mszkowalik/CE_Dongle_v3_schematic/docs/components/optical_interface.MD

Devices with similar functionality
## onemeter
https://onemeter.com/
## PiggyMeter
https://aquaticus.info/meter.html#meters-reported-to-work-with-piggymeter

In Poland most meter use IEC 62056-21

Tasmota supports Meter decoding using Sensor53
https://tasmota.github.io/docs/Smart-Meter-Interface/

Example circuit:
https://github.com/twam/IEC-62056-21-Optical-Probe
