mszkowalik/CE_Dongle_v3_schematic/enclosure/CE_Dongle_V3_3.FCStd

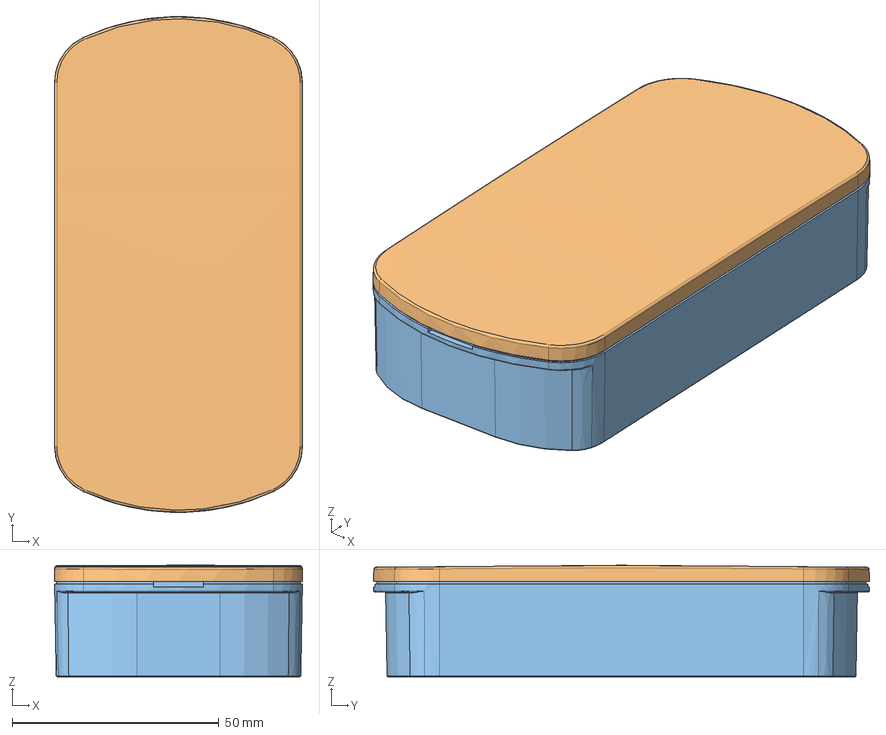
[picture p1: CAD file, 2026-07-19]
enclosure/CE_Dongle_V3_3.FCStd
60.0 x 120.0 x 27.0 mm
Binder
SICC6-12_HP\X2\7528\X0\
SIMB6-12-3W_HP\X2\7528\X0\
SIMM4-5W_HP\X2\7528\X0\
