mszkowalik/CE_Dongle_v3_schematic/enclosure/V3_0/1551RFL.stp

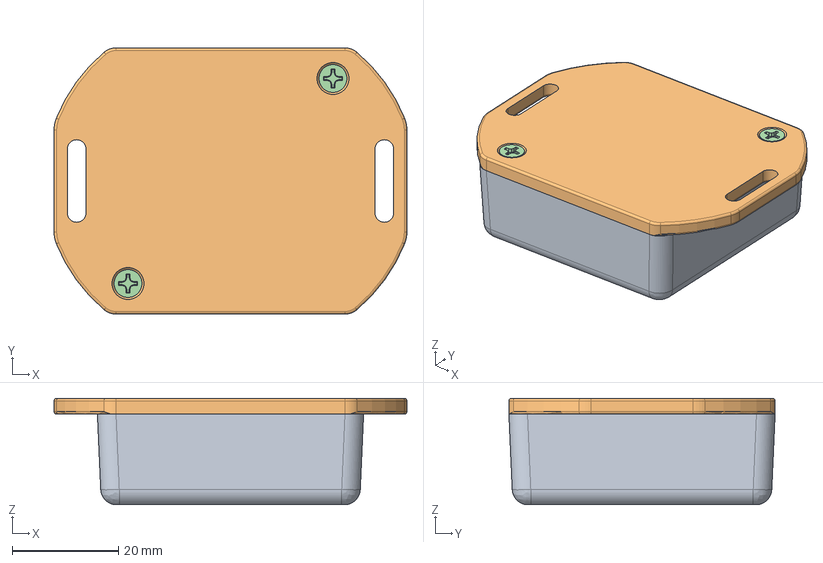
[picture p2: CAD file, 2026-05-01]
enclosure/V3_0/1551RFL.stp
66.3 x 50.0 x 20.0 mm
1551R Box
1551R-S Flange Lid
1551R-S PCB
