mszkowalik/CE_Dongle_v3_schematic/enclosure/V3_0/CE_Dongle_v3_pcb-base.3mf

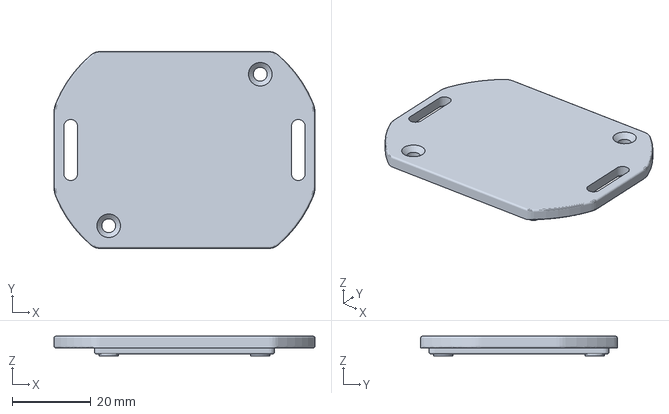
[picture p3: CAD file, 2026-05-01]
enclosure/V3_0/CE_Dongle_v3_pcb-base.3mf
66.3 x 50.0 x 5.00 mm
