mszkowalik/CE_Dongle_v3_schematic/enclosure/CE_Dongle_V3_3-BodySketch.dxf

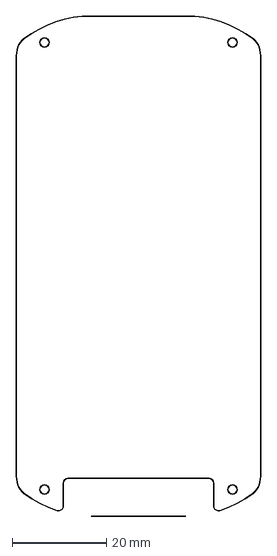
[picture p4: CAD file, 2026-07-19]
enclosure/CE_Dongle_V3_3-BodySketch.dxf
52.0 x 106.3 mm
