mszkowalik/CE_Dongle_v3_schematic/enclosure/V3_0/CE_Dongle_v3_pcb-otwory.3mf

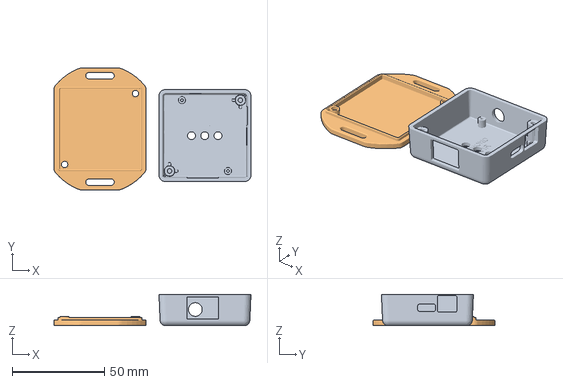
[picture p5: CAD file, 2026-05-01]
enclosure/V3_0/CE_Dongle_v3_pcb-otwory.3mf
107.0 x 66.3 x 17.0 mm
