mszkowalik/CE_Dongle_v3_schematic/enclosure/1551XFLGY.stp

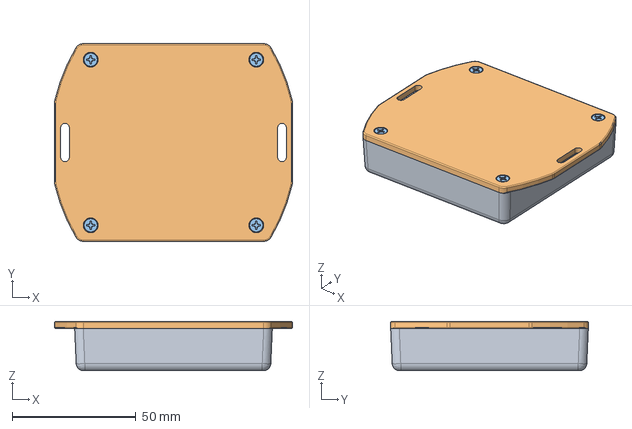
[picture p6: CAD file, 2026-07-05]
enclosure/1551XFLGY.stp
96.3 x 80.0 x 20.0 mm
1551W Box
1551W Flange Lid
