mszkowalik/CE_Dongle_v3_schematic/enclosure/CE_Dongle_v3_enc_milling.3mf

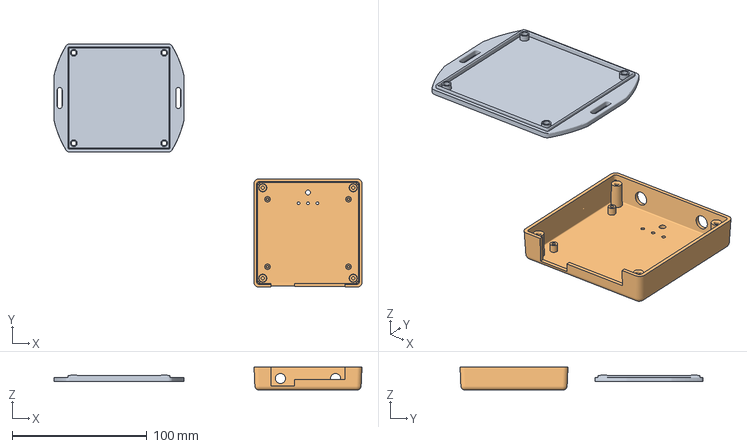
[picture p7: CAD file, 2026-07-05]
enclosure/CE_Dongle_v3_enc_milling.3mf
228.2 x 180.0 x 17.0 mm
