mszkowalik/CE_Dongle_v3_schematic/enclosure/CE_Dongle_v3_pcb.FCStd

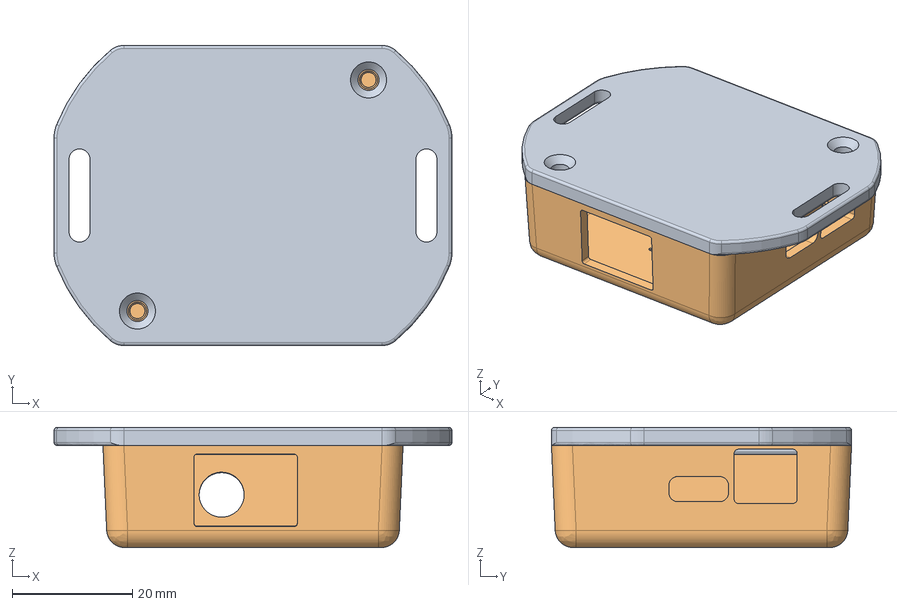
[picture p8: CAD file, 2026-05-01]
enclosure/CE_Dongle_v3_pcb.FCStd
66.3 x 50.0 x 20.0 mm
_551RFL001
