mszkowalik/CE_Dongle_v3_schematic/(list of files, cad)

Other CAD files:
enclosure/SIM6-12-3W.dxf
enclosure/CE_Dongle_v3_pcb.3mf
enclosure/V3_0/1551RFL.igs
