mszkowalik/CE_Dongle_v3_schematic/src/CE_Dongle_V3.kicad_pcb

## KiCad design src/CE_Dongle_V3.kicad_pcb (2026-07-22)

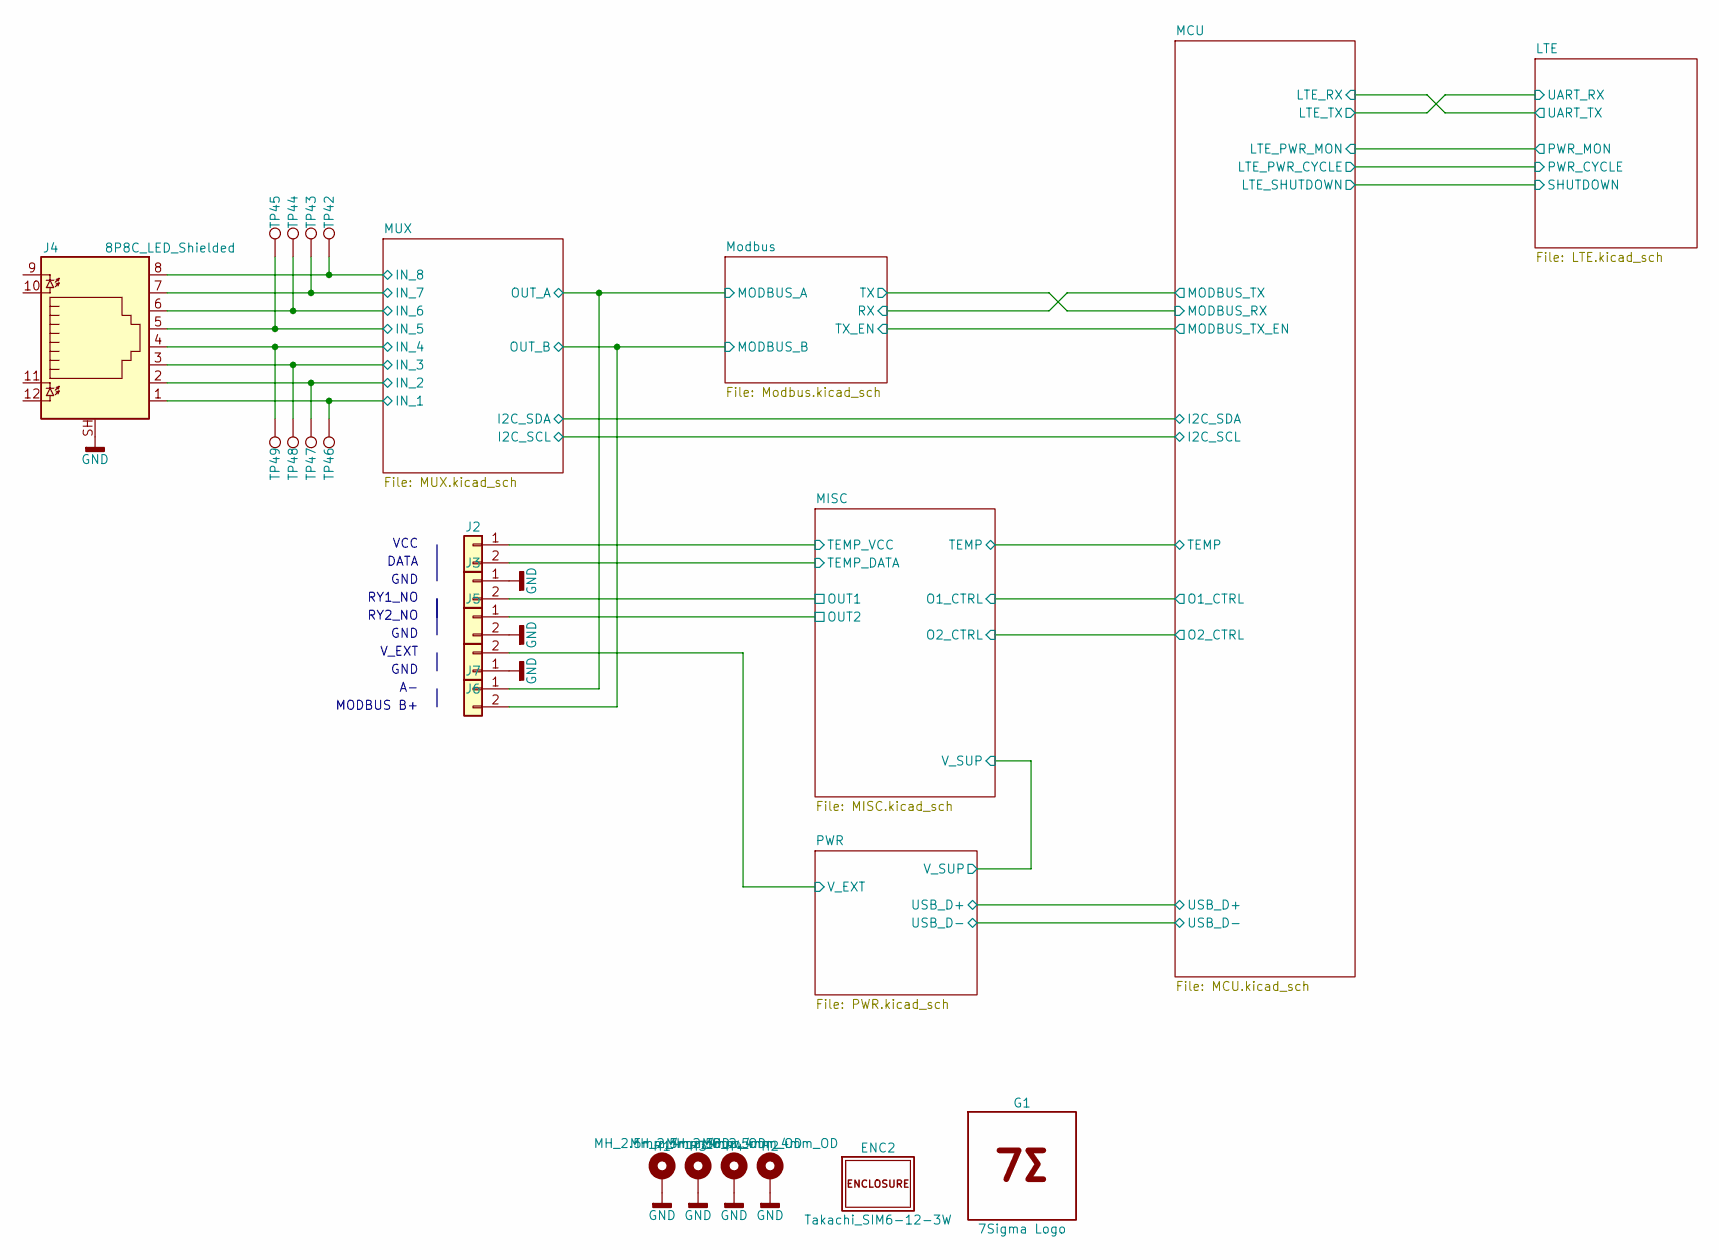
[picture p9: schematic CE_Dongle_V3.kicad_sch]

Parts:
ENC2: Takachi_SIM6-12-3W; TAKACHI_SIM6-12-3W; Manufacturer Part Numbe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 SIM6-12-3W
G1: 7Sigma Logo; 7Sigma_Logo
H1, H2, H3, H4: MH_2.5mm_4mm_OD; MountingHole_2.5mm_Pad_4mm
J2, J3, J5, J6, J7: Conn_01x02; CONN-TH_XY302V-3.5-2P; Manufacturer Part Numbe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 XY302V-3.5-2P; LCSC Part C784940
J4: 8P8C_LED_Shielded; RJ45-TH_RC01812; Manufacturer Part Numbe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 RC01812; LCSC Part C708645
TP42, TP43, TP44, TP45, TP46, TP47, TP48, TP49: TestPoint; TestPoint_Pad_D1.5mm

Connections:
/MISC/OUT1: J3.2; also elsewhere on the board
/MISC/OUT2: J5.1; also elsewhere on the board
/MISC/TEMP_DATA: J2.2; also elsewhere on the board
/MISC/TEMP_VCC: J2.1; also elsewhere on the board
/MUX/IN_1: J4.1, TP46.1 (1_1); also elsewhere on the board
/MUX/IN_2: J4.2, TP47.1 (1_1); also elsewhere on the board
/MUX/IN_3: J4.3, TP48.1 (1_1); also elsewhere on the board
/MUX/IN_4: J4.4, TP49.1 (1_1); also elsewhere on the board
/MUX/IN_5: J4.5, TP45.1 (1_1); also elsewhere on the board
/MUX/IN_6: J4.6, TP44.1 (1_1); also elsewhere on the board
/MUX/IN_7: J4.7, TP43.1 (1_1); also elsewhere on the board
/MUX/IN_8: J4.8, TP42.1 (1_1); also elsewhere on the board
/MUX/OUT_A: J7.1; also elsewhere on the board
/MUX/OUT_B: J7.2; also elsewhere on the board
/PWR/V_EXT: J6.2; also elsewhere on the board
GND: H1.1 (1_1), H2.1 (1_1), H3.1 (1_1), H4.1 (1_1), J3.1, J4.SH, J5.2, J6.1; also elsewhere on the board

Notes on the sheet:
VCC
GND
V_EXT
RY1_NO
DATA
MODBUS B+
RY2_NO

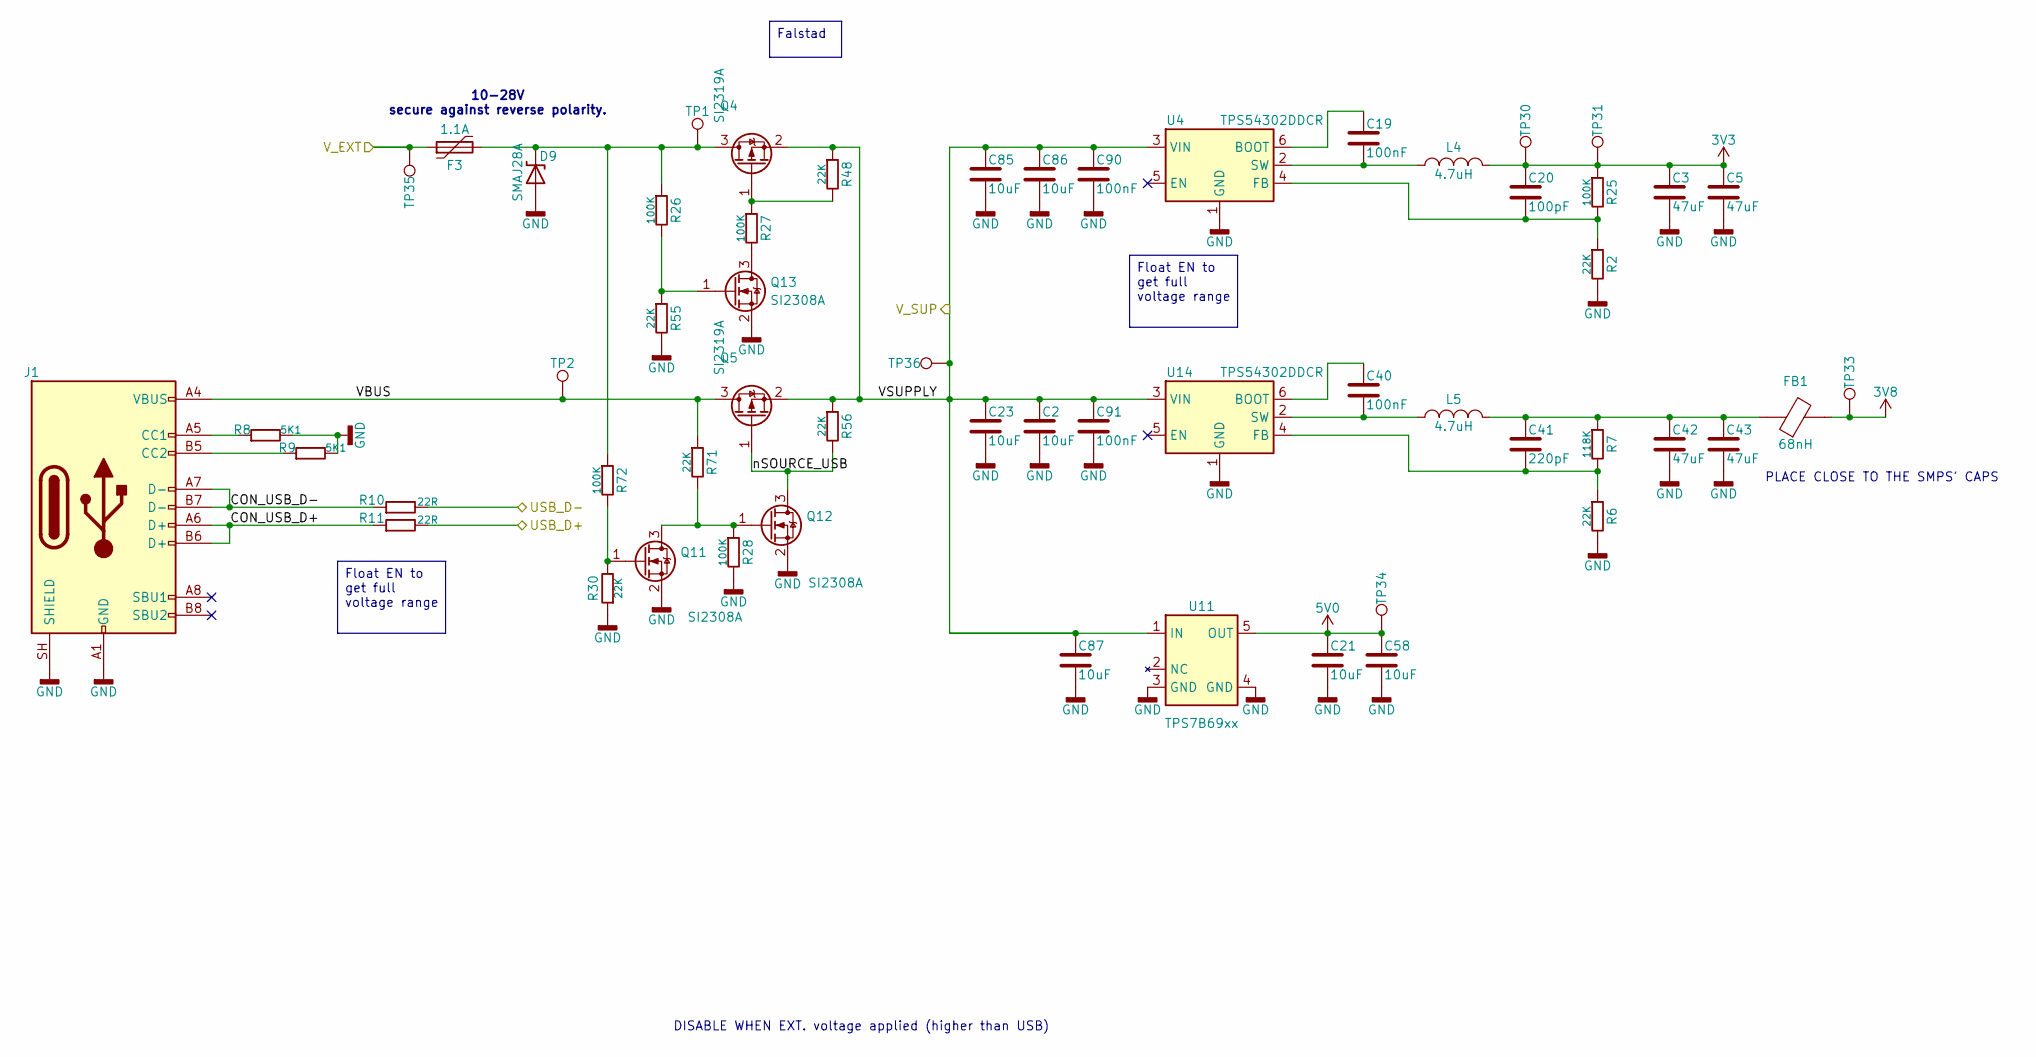
[picture p10: schematic PWR.kicad_sch]

Parts:
C2, C21, C23, C58, C85, C86, C87: 10uF; C_0805_2012Metric; Voltage 50V; Tolerance 10%; Manufacturer Part Numbe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 GRM21BR61H106KE43L; LCSC Part C440198
C3, C5, C42, C43: 47uF; C_1210_3225Metric; Voltage 16V; Tolerance 10%; Manufacturer Part Numbe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 CS3225X7R476K160NRL; LCSC Part C5440143
C19, C40, C90, C91: 100nF; C_0402_1005Metric; Voltage 16V; Tolerance 10%; Manufacturer Part Numbe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 CL05B104KO5NNNC; LCSC Part C1525
C20: 100pF; C_0402_1005Metric; Voltage 50V; Tolerance 5%; Manufacturer Part Numbe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 0402CG101J500NT; LCSC Part C1546
C41: 220pF; C_0402_1005Metric; Voltage 50V; Tolerance 5%; Manufacturer Part Numbe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 CC0402JRNPO9BN221; LCSC Part C107001
D9: SMAJ28A; D_SMA; Voltage - Breakdown 34.4V; Clamping Voltage 45.4V; Manufacturer Part Numbe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 SMAJ28A; LCSC Part C148227
F3: 1.1A; Fuse_1206_3216Metric; Voltage_Max 30V; Manufacturer Part Numbe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 BSMD1206-110-30V; LCSC Part C21714343
FB1: 68nH; L_0603_1608Metric; Tolerance 25%; Manufacturer Part Numbe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 BLM18EG101TN1D; LCSC Part C76893
J1: USB_C_Receptacle_USB2.0_16P; USB-3.1-SMD_U262-161N-4BVC11; Manufacturer Part Numbe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 U262-161N-4BVC11; LCSC Part C319148
L4, L5: 4.7uH; L_Changjiang_FTC404030S; Tolerance 20%; Manufacturer Part Numbe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 FTC404030S4R7MGCA; LCSC Part C39676083
Q4, Q5: SI2319A; SOT-23-3; Manufacturer Part Numbe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 SI2319A; LCSC Part C545576
Q11, Q12, Q13: SI2308A; SOT-23-3; Manufacturer Part Numbe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 SI2308A; LCSC Part C347491
R2, R6, R30, R48, R55, R56, R71: 22K; R_0402_1005Metric; Tolerance 1%; Manufacturer Part Numbe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 0402WGF2202TCE; LCSC Part C25768
R7: 118K; R_0402_1005Metric; Tolerance 1%; Manufacturer Part Numbe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 0402WGF1183TCE; LCSC Part C25748
R8, R9: 5K1; R_0402_1005Metric; Tolerance 1%; Manufacturer Part Numbe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 0402WGF5101TCE; LCSC Part C25905
R10, R11: 22R; R_0402_1005Metric; Tolerance 1%; Manufacturer Part Numbe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 0402WGF220JTCE; LCSC Part C25092
R25, R26, R27, R28, R72: 100K; R_0402_1005Metric; Tolerance 1%; Manufacturer Part Numbe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 0402WGF1003TCE; LCSC Part C25741
TP1, TP2, TP30, TP31, TP33, TP34, TP35, TP36: TestPoint; TestPoint_Pad_D1.5mm
U4, U14: TPS54302DDCR; SOT-23-6; Output Voltage Adj; Input Voltage 4.5V~28V; Manufacturer Part Numbe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 TPS54302DDCR; LCSC Part C311983
U11: TPS7B69xx; SOT-23-5; Output Voltage 5V; Dropout Voltage 450mV@(100mA); Manufacturer Part Numbe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 TPS7B6950QDBVRQ1; LCSC Part C132202

Connections:
3V3: C3.1, C5.1, C20.1, L4.2, R25.1, TP30.1 (1_1), TP31.1 (1_1); also elsewhere on the board
3V8: FB1.2, TP33.1 (1_1); also elsewhere on the board
5V0: C21.1, C58.1, TP34.1 (1_1), U11.5 (OUT); also elsewhere on the board
/MCU/USB_D+: R11.2; also elsewhere on the board
/MCU/USB_D-: R10.2; also elsewhere on the board
/MISC/VSUPPLY: C2.1, C23.1, C85.1, C86.1, C87.1, C90.1, C91.1, Q4.2 (S), Q5.2 (S), R48.1, R56.1, TP36.1 (1_1), U4.3 (VIN), U11.1 (IN), U14.3 (VIN); also elsewhere on the board
/PWR/CON_USB_D+: J1.A6 (D+), J1.B6 (D+), R11.1
/PWR/CON_USB_D-: J1.A7 (D-), J1.B7 (D-), R10.1
/PWR/VBUS: J1.A4 (VBUS), J1.A9 (VBUS), J1.B4 (VBUS), J1.B9 (VBUS), Q5.3 (D), R71.1, TP2.1 (1_1)
/PWR/V_EXT: F3.1, TP35.1 (1_1); also elsewhere on the board
/PWR/nSOURCE_USB: Q5.1 (G), Q12.3 (D), R56.2
GND: C2.2, C3.2, C5.2, C21.2, C23.2, C42.2, C43.2, C58.2, C85.2, C86.2, C87.2, C90.2, C91.2, D9.2 (A), J1.A1 (GND), J1.A12 (GND), J1.B1 (GND), J1.B12 (GND), J1.SH (SHIELD), Q11.2 (S), Q12.2 (S), Q13.2 (S), R2.2, R6.2, R8.2, R9.2, R28.2, R30.1, R55.2, U4.1 (GND), U11.3 (GND), U11.4 (GND), U14.1 (GND); also elsewhere on the board
unnamed: C41.1, C42.1, C43.1, FB1.1, L5.2, R7.1
unnamed: D9.1 (C), F3.2, Q4.3 (D), R26.1, R72.1, TP1.1 (1_1)
unnamed: J1.A5 (CC1), R8.1
unnamed: J1.B5 (CC2), R9.1
unnamed: Q4.1 (G), R27.1, R48.2
unnamed: Q11.3 (D), Q12.1 (G), R28.1, R71.2
unnamed: Q11.1 (G), R30.2, R72.2
unnamed: Q13.3 (D), R27.2
unnamed: Q13.1 (G), R26.2, R55.1
unnamed: C19.1, U4.6 (BOOT)
unnamed: C20.2, R2.1, R25.2, U4.4 (FB)
unnamed: C19.2, L4.1, U4.2 (SW)
unnamed: C40.1, U14.6 (BOOT)
unnamed: C41.2, R6.1, R7.2, U14.4 (FB)
unnamed: C40.2, L5.1, U14.2 (SW)

Notes on the sheet:
10-28V secure against reverse polarity.
DISABLE WHEN EXT. voltage applied (higher than USB)
PLACE CLOSE TO THE SMPS' CAPS
Float EN to get full voltage range
Falstad

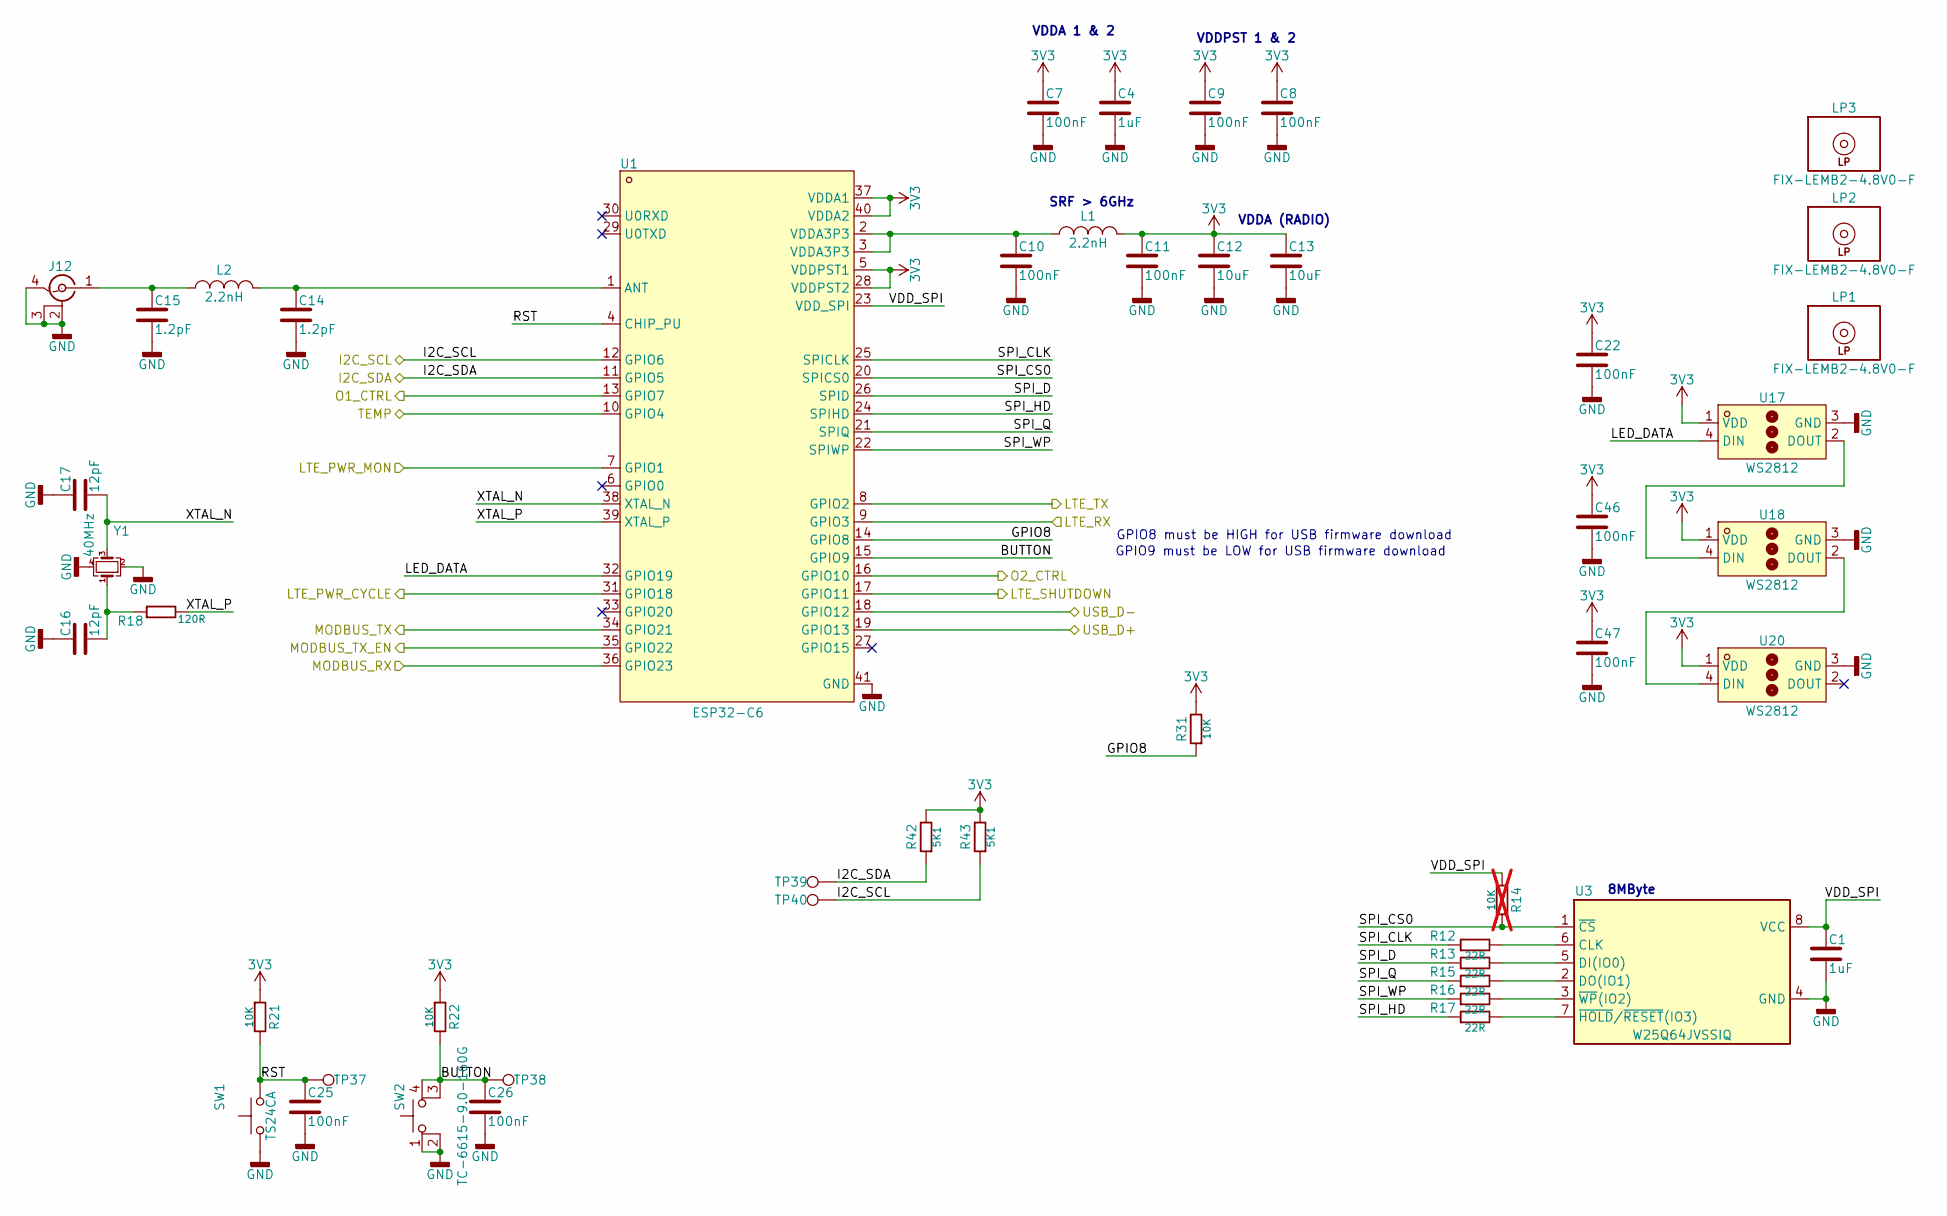
[picture p11: schematic MCU.kicad_sch]

Parts:
C1, C4: 1uF; C_0402_1005Metric; Voltage 50V; Tolerance 1%; Manufacturer Part Numbe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 GRM155R61H105KE05D; LCSC Part C1518208
C7, C8, C9, C10, C11, C22, C25, C26, C46, C47: 100nF; C_0402_1005Metric; Voltage 16V; Tolerance 10%; Manufacturer Part Numbe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 CL05B104KO5NNNC; LCSC Part C1525
C12, C13: 10uF; C_0402_1005Metric; Voltage 10V; Tolerance 10%; Manufacturer Part Numbe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 CL05A106MP5NUNC; LCSC Part C315248
C14, C15: 1.2pF; C_0402_1005Metric; Voltage 50V; Tolerance 0.05pF; Manufacturer Part Numbe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 GJM1555C1H1R2WB01D; LCSC Part C76899
C16, C17: 12pF; C_0402_1005Metric; Voltage 50V; Tolerance 5%; Manufacturer Part Numbe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 CC0402JRNPO9BN120; LCSC Part C106201
J12: Conn_IPEX; ANT-SMD_KH-IPEX-K501-29; Manufacturer Part Numbe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 KH-IPEX-K501-29; LCSC Part C411563
L1, L2: 2.2nH; L_0402_1005Metric; Tolerance 10%; Manufacturer Part Numbe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 LQW15AN2N2C10D; LCSC Part C91240
LP1, LP2, LP3: FIX-LEMB2-4.8V0-F; Manufacturer Part Numbe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 FIX-LEMB2-4.8V0-F
R12, R13, R15, R16, R17: 22R; R_0402_1005Metric; Tolerance 1%; Manufacturer Part Numbe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 0402WGF220JTCE; LCSC Part C25092
R14: 10K; R_0402_1005Metric; Tolerance 1%; Manufacturer Part Numbe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 0402WGF1002TCE; LCSC Part C25744; not fitted
R18: 120R; R_0402_1005Metric; Tolerance 1%; Manufacturer Part Numbe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 0402WGF1200TCE; LCSC Part C25079
R21, R22, R31: 10K; R_0402_1005Metric; Tolerance 1%; Manufacturer Part Numbe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 0402WGF1002TCE; LCSC Part C25744
R42, R43: 5K1; R_0402_1005Metric; Tolerance 1%; Manufacturer Part Numbe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 0402WGF5101TCE; LCSC Part C25905
SW1: TS24CA; SW-SMD_TS24CA; Manufacturer Part Numbe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 TS24CA; LCSC Part C393942
SW2: TC-6615-9.0-160G; SW-TH_4P-RA-L6.0-W6.0-H9.0; Manufacturer Part Numbe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 TC-6615-9.0-160G; LCSC Part C6575016
TP37, TP38, TP39, TP40: TestPoint; TestPoint_Pad_D1.5mm
U1: ESP32-C6; VQFN-40-1EP_5x5mm_P0.4mm_EP3.3x3.3mm_ThermalVias; Manufacturer Part Numbe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 ESP32-C6; LCSC Part C5364646
U3: W25Q64JVSSIQ; SOIC-8_5.3x5.3mm_P1.27mm; Voltage Range 2.7V~3.6V; Manufacturer Part Numbe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 W25Q64JVSSIQ; LCSC Part C179171
U17, U18, U20: WS2812; LED-SMD_4P-L1.3-W1.3-P0.80_WS2812E-1313; Voltage Range 3.7V~5.3V; Manufacturer Part Numbe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 WS2812E-1313; LCSC Part C5446700
Y1: 40MHz; Crystal_SMD_3225-4Pin_3.2x2.5mm; Tolerance 10ppm; Manufacturer Part Numbe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 XTM32040000FT00351001; LCSC Part C37635390

Connections:
3V3: C4.1, C7.1, C8.1, C9.1, C11.1, C12.1, C13.1, C22.1, C46.1, C47.1, L1.2, R21.1, R22.1, R31.2, R42.2, R43.2, U1.5 (VDDPST1), U1.28 (VDDPST2), U1.37 (VDDA1), U1.40 (VDDA2), U17.1 (VDD), U18.1 (VDD), U20.1 (VDD); also elsewhere on the board
/LTE/PWR_CYCLE: U1.31 (GPIO18); also elsewhere on the board
/LTE/PWR_MON: U1.7 (GPIO1); also elsewhere on the board
/LTE/SHUTDOWN: U1.17 (GPIO11); also elsewhere on the board
/LTE/UART_RX: U1.8 (GPIO2); also elsewhere on the board
/LTE/UART_TX: U1.9 (GPIO3); also elsewhere on the board
/MCU/BUTTON: C26.1, R22.2, SW2.3 (K), SW2.4 (A), TP38.1 (1_1), U1.15 (GPIO9)
/MCU/GPIO8: R31.1, U1.14 (GPIO8)
/MCU/I2C_SCL: R43.1, TP40.1 (1_1), U1.12 (GPIO6); also elsewhere on the board
/MCU/I2C_SDA: R42.1, TP39.1 (1_1), U1.11 (GPIO5); also elsewhere on the board
/MCU/LED_DATA: U1.32 (GPIO19), U17.4 (DIN)
/MCU/MODBUS_RX: U1.36 (GPIO23); also elsewhere on the board
/MCU/MODBUS_TX: U1.34 (GPIO21); also elsewhere on the board
/MCU/MODBUS_TX_EN: U1.35 (GPIO22); also elsewhere on the board
/MCU/O1_CTRL: U1.13 (GPIO7); also elsewhere on the board
/MCU/O2_CTRL: U1.16 (GPIO10); also elsewhere on the board
/MCU/RST: C25.1, R21.2, SW1.2, TP37.1 (1_1), U1.4 (CHIP_PU)
/MCU/SPI_CLK: R12.1, U1.25 (SPICLK)
/MCU/SPI_CS0: R14.2, U1.20 (SPICS0), U3.1 (~CS)
/MCU/SPI_D: R13.1, U1.26 (SPID)
/MCU/SPI_HD: R17.1, U1.24 (SPIHD)
/MCU/SPI_Q: R15.1, U1.21 (SPIQ)
/MCU/SPI_WP: R16.1, U1.22 (SPIWP)
/MCU/USB_D+: U1.19 (GPIO13); also elsewhere on the board
/MCU/USB_D-: U1.18 (GPIO12); also elsewhere on the board
/MCU/VDD_SPI: C1.1, R14.1, U1.23 (VDD_SPI), U3.8 (VCC)
/MCU/XTAL_N: C17.2, U1.38 (XTAL_N), Y1.3
/MCU/XTAL_P: R18.2, U1.39 (XTAL_P)
/MISC/TEMP: U1.10 (GPIO4); also elsewhere on the board
GND: C1.2, C4.2, C7.2, C8.2, C9.2, C10.2, C11.2, C12.2, C13.2, C14.2, C15.2, C16.1, C17.1, C22.2, C25.2, C26.2, C46.2, C47.2, J12.2 (Ext), J12.3 (Ext), J12.4 (PT), SW1.1, SW2.1, SW2.2, U1.41 (GND), U3.4 (GND), U17.3 (GND), U18.3 (GND), U20.3 (GND), Y1.2, Y1.4; also elsewhere on the board
unnamed: C10.1, L1.1, U1.2 (VDDA3P3), U1.3 (VDDA3P3)
unnamed: C16.2, R18.1, Y1.1
unnamed: C15.1, J12.1 (In), L2.1
unnamed: C14.1, L2.2, U1.1 (ANT)
unnamed: R12.2, U3.6 (CLK)
unnamed: R13.2, U3.5 (DI(IO0))
unnamed: R15.2, U3.2 (DO(IO1))
unnamed: R17.2, U3.7 (~HOLD/~RESET(IO3))
unnamed: R16.2, U3.3 (~WP(IO2))
unnamed: U17.2 (DOUT), U18.4 (DIN)
unnamed: U18.2 (DOUT), U20.4 (DIN)

Notes on the sheet:
VDDA (RADIO)
SRF > 6GHz
GPIO8 must be HIGH for USB firmware download
VDDA 1 & 2
8MByte
VDDPST 1 & 2
GPIO9 must be LOW for USB firmware download

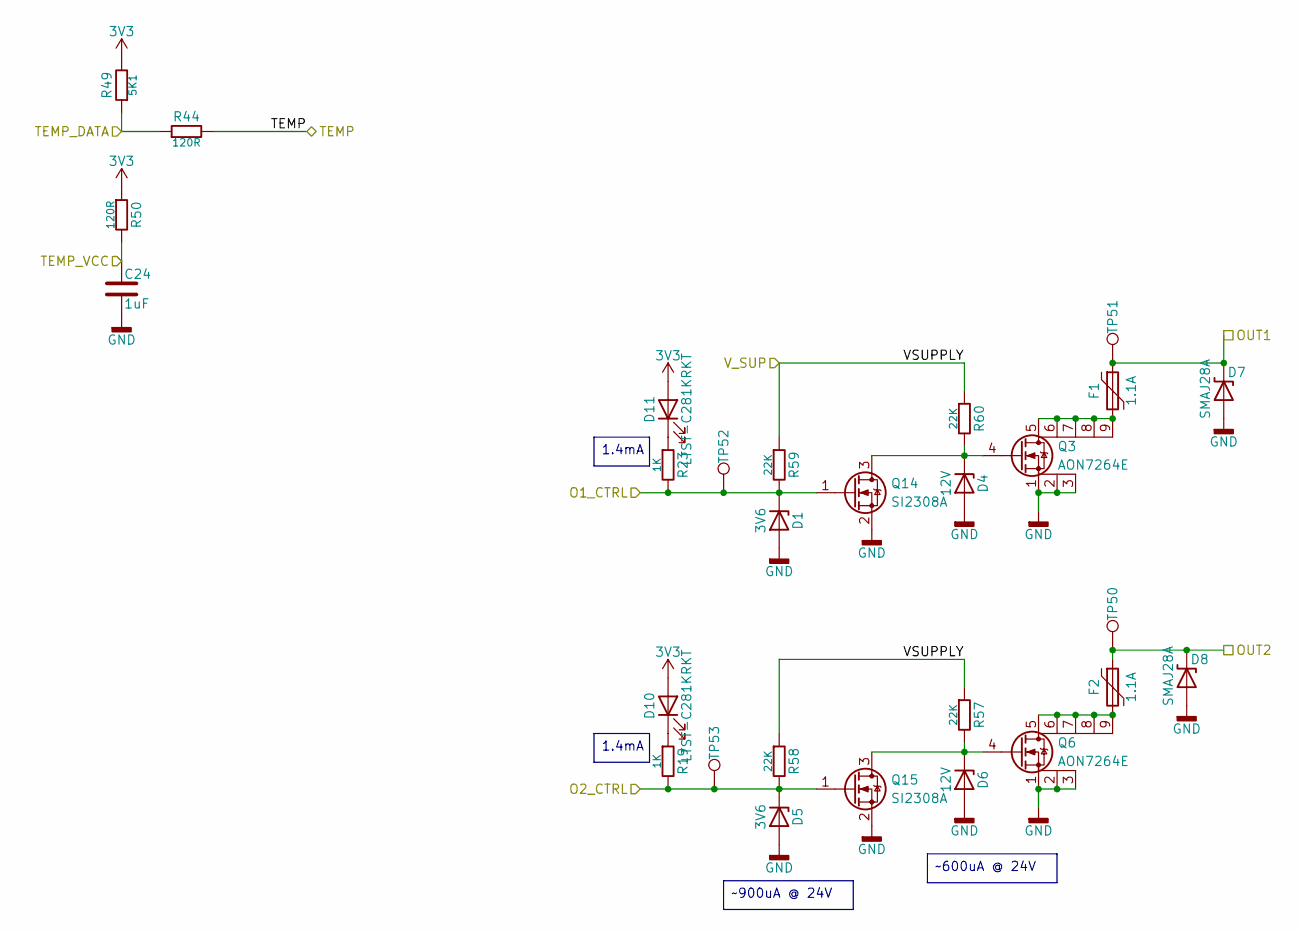
[picture p12: schematic MISC.kicad_sch]

Parts:
C24: 1uF; C_0402_1005Metric; Voltage 50V; Tolerance 1%; Manufacturer Part Numbe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 GRM155R61H105KE05D; LCSC Part C1518208
D1, D5: 3V6; D_SOD-323; Zenner Voltage 3.6V; Tolerance 5%; Manufacturer Part Numbe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 BZX384-C3V6,115; LCSC Part C454986
D4, D6: 12V; D_SOD-323; Zenner Voltage 12V; Tolerance 5%; Manufacturer Part Numbe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 BZX384-C12,115; LCSC Part C454968
D7, D8: SMAJ28A; D_SMA; Voltage - Breakdown 34.4V; Clamping Voltage 45.4V; Manufacturer Part Numbe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 SMAJ28A; LCSC Part C148227
D10, D11: LTST-C281KRKT; LED_0402_1005Metric; Forward Voltage 2V; Manufacturer Part Numbe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 LTST-C281KRKT; LCSC Part C364556
F1, F2: 1.1A; Fuse_1206_3216Metric; Voltage_Max 30V; Manufacturer Part Numbe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 BSMD1206-110-30V; LCSC Part C21714343
Q3, Q6: AON7264E; DFN-8-1EP_3x3mm_P0.65mm_EP1.55x2.4mm; Manufacturer Part Numbe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 AON7264E; LCSC Part C431191
Q14, Q15: SI2308A; SOT-23-3; Manufacturer Part Numbe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 SI2308A; LCSC Part C347491
R19, R23: 1K; R_0402_1005Metric; Tolerance 1%; Manufacturer Part Numbe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 0402WGF1001TCE; LCSC Part C11702
R44: 120R; R_0402_1005Metric; Tolerance 1%; Manufacturer Part Numbe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 0402WGF1200TCE; LCSC Part C25079
R49: 5K1; R_0402_1005Metric; Tolerance 1%; Manufacturer Part Numbe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 0402WGF5101TCE; LCSC Part C25905
R50: 120R; R_0805_2012Metric; Tolerance 1%; Manufacturer Part Numbe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 0805W8F1200T5E; LCSC Part C17437
R57, R58, R59, R60: 22K; R_0402_1005Metric; Tolerance 1%; Manufacturer Part Numbe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 0402WGF2202TCE; LCSC Part C25768
TP50, TP51, TP52, TP53: TestPoint; TestPoint_Pad_D1.5mm

Connections:
3V3: D10.2 (A), D11.2 (A), R49.2, R50.1; also elsewhere on the board
/MCU/O1_CTRL: D1.1 (K), Q14.1 (G), R23.2, R59.2, TP52.1 (1_1); also elsewhere on the board
/MCU/O2_CTRL: D5.1 (K), Q15.1 (G), R19.2, R58.2, TP53.1 (1_1); also elsewhere on the board
/MISC/OUT1: D7.1 (C), F1.1, TP51.1 (1_1); also elsewhere on the board
/MISC/OUT2: D8.1 (C), F2.1, TP50.1 (1_1); also elsewhere on the board
/MISC/TEMP: R44.2; also elsewhere on the board
/MISC/TEMP_DATA: R44.1, R49.1; also elsewhere on the board
/MISC/TEMP_VCC: C24.1, R50.2; also elsewhere on the board
/MISC/VSUPPLY: R57.1, R58.1, R59.1, R60.1; also elsewhere on the board
GND: C24.2, D1.2 (A), D4.2 (A), D5.2 (A), D6.2 (A), D7.2 (A), D8.2 (A), Q3.1 (S), Q3.2 (S), Q3.3 (S), Q6.1 (S), Q6.2 (S), Q6.3 (S), Q14.2 (S), Q15.2 (S); also elsewhere on the board
unnamed: D4.1 (K), Q3.4 (G), Q14.3 (D), R60.2
unnamed: D6.1 (K), Q6.4 (G), Q15.3 (D), R57.2
unnamed: D10.1 (K), R19.1
unnamed: D11.1 (K), R23.1
unnamed: F1.2, Q3.5 (D), Q3.6 (D), Q3.7 (D), Q3.8 (D), Q3.9 (D)
unnamed: F2.2, Q6.5 (D), Q6.6 (D), Q6.7 (D), Q6.8 (D), Q6.9 (D)

Notes on the sheet:
~600uA @ 24V
1.4mA
~900uA @ 24V

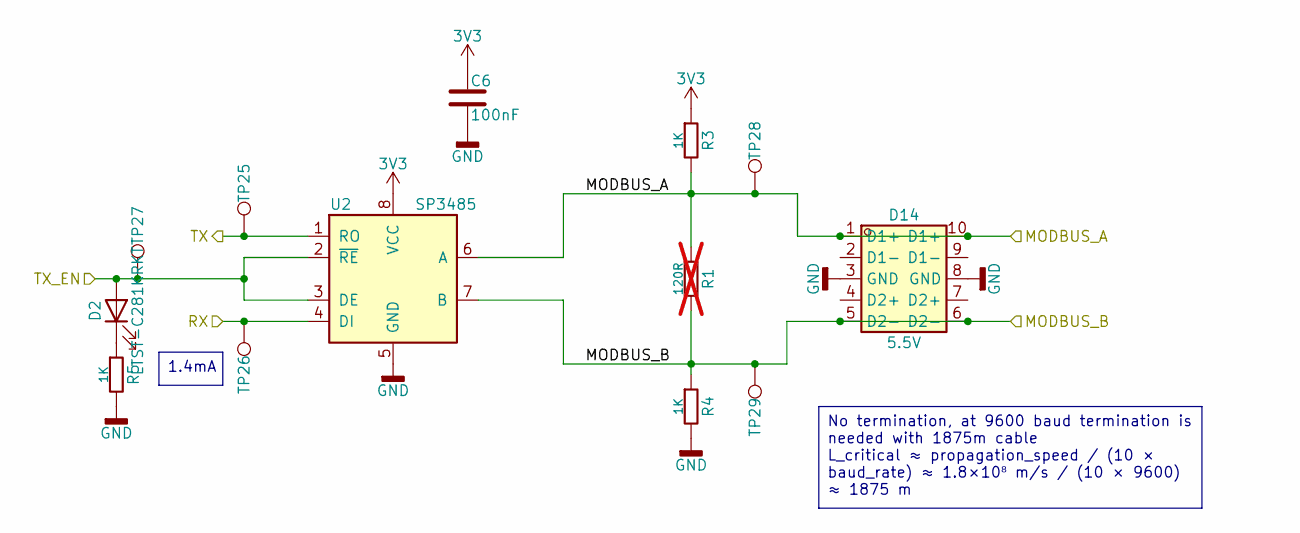
[picture p13: schematic Modbus.kicad_sch]

Parts:
C6: 100nF; C_0402_1005Metric; Voltage 16V; Tolerance 10%; Manufacturer Part Numbe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 CL05B104KO5NNNC; LCSC Part C1525
D2: LTST-C281KRKT; LED_0402_1005Metric; Forward Voltage 2V; Manufacturer Part Numbe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 LTST-C281KRKT; LCSC Part C364556
D14: 5.5V; USON-10_2.5x1.0mm_P0.5mm; Voltage - Breakdown 6.5V; LCSC Part C138714
R1: 120R; R_0402_1005Metric; Tolerance 1%; Manufacturer Part Numbe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 0402WGF1200TCE; LCSC Part C25079; not fitted
R3, R4, R5: 1K; R_0402_1005Metric; Tolerance 1%; Manufacturer Part Numbe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 0402WGF1001TCE; LCSC Part C11702
TP25, TP26, TP27, TP28, TP29: TestPoint; TestPoint_Pad_D1.5mm
U2: SP3485; SOIC-8_3.9x4.9mm_P1.27mm; Manufacturer Part Numbe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 SP3485EN-L/TR; LCSC Part C8963

Connections:
3V3: C6.1, R3.1, U2.8 (VCC); also elsewhere on the board
/MCU/MODBUS_RX: TP25.1 (1_1), U2.1 (RO); also elsewhere on the board
/MCU/MODBUS_TX: TP26.1 (1_1), U2.4 (DI); also elsewhere on the board
/MCU/MODBUS_TX_EN: D2.2 (A), TP27.1 (1_1), U2.2 (~RE), U2.3 (DE); also elsewhere on the board
/MUX/OUT_A: D14.1 (D1+), D14.10 (D1+), R1.1, R3.2, TP28.1 (1_1), U2.6 (A); also elsewhere on the board
/MUX/OUT_B: D14.5 (D2-), D14.6 (D2-), R1.2, R4.1, TP29.1 (1_1), U2.7 (B); also elsewhere on the board
GND: C6.2, D14.3 (GND), D14.8 (GND), R4.2, R5.2, U2.5 (GND); also elsewhere on the board
unnamed: D2.1 (K), R5.1

Notes on the sheet:
1.4mA
No termination, at 9600 baud termination is needed with 1875m cable L_critical ≈ propagation_speed / (10 × baud_rate) ≈ 1.8×10⁸ m/s / (10 × 9600) ≈ 1875 m

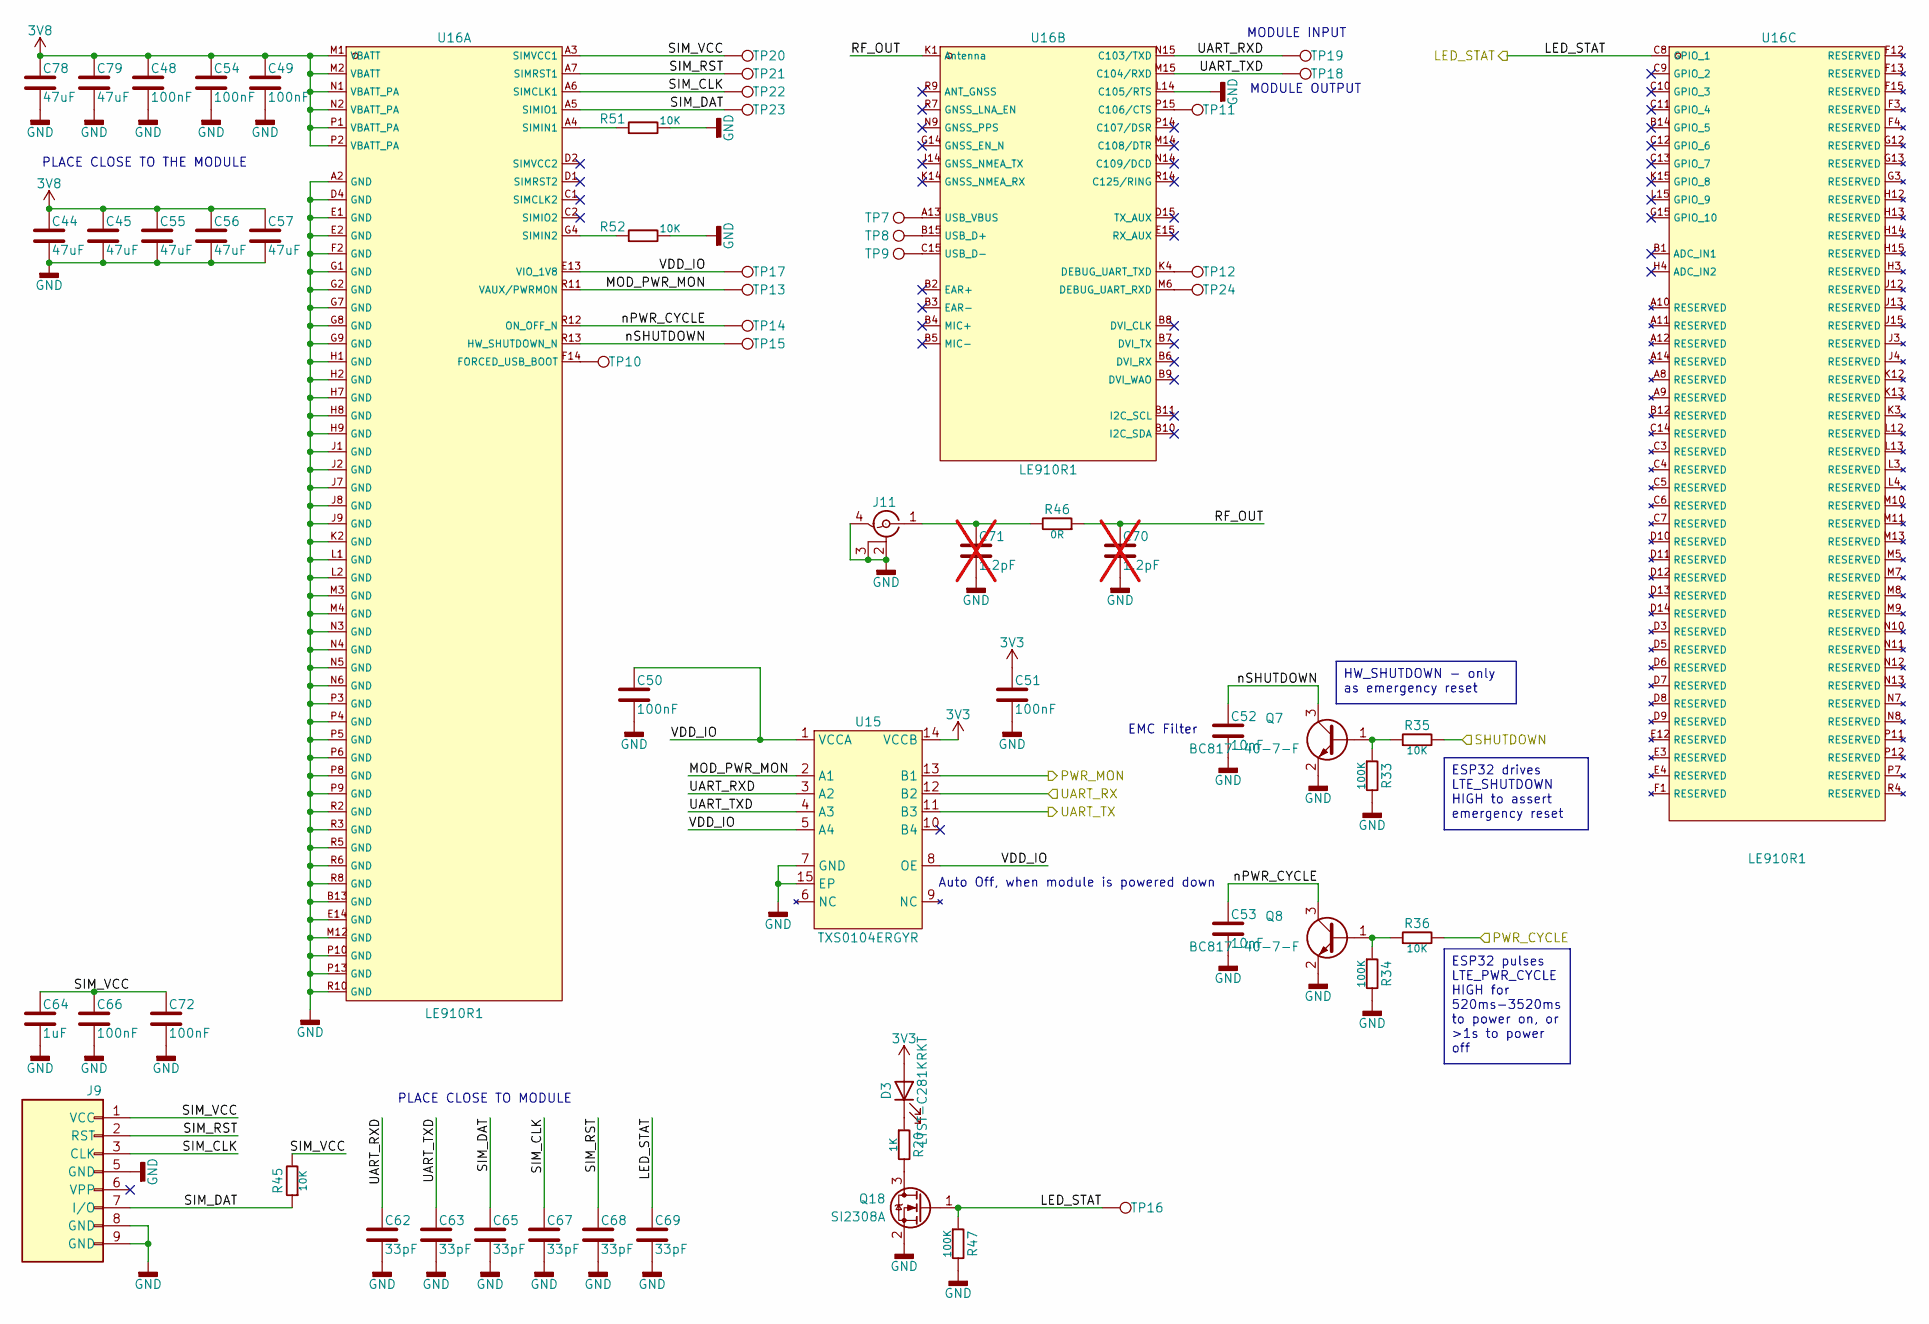
[picture p14: schematic LTE.kicad_sch]

Parts:
C44, C45, C55, C56, C57, C78, C79: 47uF; C_1210_3225Metric; Voltage 16V; Tolerance 10%; Manufacturer Part Numbe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 CS3225X7R476K160NRL; LCSC Part C5440143
C48, C49, C50, C51, C54, C66, C72: 100nF; C_0402_1005Metric; Voltage 16V; Tolerance 10%; Manufacturer Part Numbe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 CL05B104KO5NNNC; LCSC Part C1525
C52, C53: 10nF; C_0402_1005Metric; Voltage 50V; Tolerance 10%; Manufacturer Part Numbe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 CL05B103KB5NNNC; LCSC Part C15195
C62, C63, C65, C67, C68, C69: 33pF; C_0402_1005Metric; Voltage 50V; Tolerance 5%; Manufacturer Part Numbe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 CC0402JRNPO9BN330; LCSC Part C107005
C64: 1uF; C_0402_1005Metric; Voltage 50V; Tolerance 1%; Manufacturer Part Numbe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 GRM155R61H105KE05D; LCSC Part C1518208
C70, C71: 1.2pF; C_0402_1005Metric; Voltage 50V; Tolerance 0.05pF; Manufacturer Part Numbe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 GJM1555C1H1R2WB01D; LCSC Part C76899; not fitted
D3: LTST-C281KRKT; LED_0402_1005Metric; Forward Voltage 2V; Manufacturer Part Numbe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 LTST-C281KRKT; LCSC Part C364556
J9: SIM_NANO_Socket; SIM-SMD_NANO-SIM-TL6P-H1.35; Manufacturer Part Numbe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 NANO SIM TL6P H1.35; LCSC Part C7529385
J11: Conn_IPEX; ANT-SMD_KH-IPEX-K501-29; Manufacturer Part Numbe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 KH-IPEX-K501-29; LCSC Part C411563
Q7, Q8: BC817-40-7-F; SOT-23-3; Manufacturer Part Numbe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 BC817-40-7-F; LCSC Part C435867
Q18: SI2308A; SOT-23-3; Manufacturer Part Numbe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 SI2308A; LCSC Part C347491
R20: 1K; R_0402_1005Metric; Tolerance 1%; Manufacturer Part Numbe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 0402WGF1001TCE; LCSC Part C11702
R33, R34, R47: 100K; R_0402_1005Metric; Tolerance 1%; Manufacturer Part Numbe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 0402WGF1003TCE; LCSC Part C25741
R35, R36, R45, R51, R52: 10K; R_0402_1005Metric; Tolerance 1%; Manufacturer Part Numbe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 0402WGF1002TCE; LCSC Part C25744
R46: 0R; R_0402_1005Metric; Tolerance 1%; Manufacturer Part Numbe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 0402WGF0000TCE; LCSC Part C17168
TP7, TP8, TP9, TP10, TP11, TP12, TP13, TP14, TP15, TP16, TP17, TP18, TP19, TP20, TP21, TP22, TP23, TP24: TestPoint; TestPoint_Pad_D1.5mm
U15: TXS0104ERGYR; VQFN-14_L3.5-W3.5-P0.50-BL-EP-ThermalVias; Manufacturer Part Numbe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 TXS0104ERGYR; LCSC Part C154926
U16: LE910R1; XCVR_LE910R1-EU; Manufacturer Part Numbe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 LE910R1-EU

Connections:
3V3: C51.1, D3.2 (A), U15.14 (VCCB); also elsewhere on the board
3V8: C44.1, C45.1, C48.1, C49.1, C54.1, C55.1, C56.1, C57.1, C78.1, C79.1, U16.M1 (VBATT), U16.M2 (VBATT), U16.N1 (VBATT_PA), U16.N2 (VBATT_PA), U16.P1 (VBATT_PA), U16.P2 (VBATT_PA); also elsewhere on the board
/LTE/LED_STAT: C69.1, Q18.1 (G), R47.1, TP16.1 (1_1), U16.C8 (GPIO_1)
/LTE/MOD_PWR_MON: TP13.1 (1_1), U15.2 (A1), U16.R11 (VAUX/PWRMON)
/LTE/PWR_CYCLE: R36.2; also elsewhere on the board
/LTE/PWR_MON: U15.13 (B1); also elsewhere on the board
/LTE/RF_OUT: C70.1, R46.1, U16.K1 (Antenna)
/LTE/SHUTDOWN: R35.2; also elsewhere on the board
/LTE/SIM_CLK: C67.1, J9.3 (CLK), TP22.1 (1_1), U16.A6 (SIMCLK1)
/LTE/SIM_DAT: C65.1, J9.7 (I/O), R45.1, TP23.1 (1_1), U16.A5 (SIMIO1)
/LTE/SIM_RST: C68.1, J9.2 (RST), TP21.1 (1_1), U16.A7 (SIMRST1)
/LTE/SIM_VCC: C64.1, C66.1, C72.1, J9.1 (VCC), R45.2, TP20.1 (1_1), U16.A3 (SIMVCC1)
/LTE/UART_RX: U15.12 (B2); also elsewhere on the board
/LTE/UART_RXD: C62.1, TP19.1 (1_1), U15.3 (A2), U16.N15 (C103/TXD)
/LTE/UART_TX: U15.11 (B3); also elsewhere on the board
/LTE/UART_TXD: C63.1, TP18.1 (1_1), U15.4 (A3), U16.M15 (C104/RXD)
/LTE/VDD_IO: C50.1, TP17.1 (1_1), U15.1 (VCCA), U15.5 (A4), U15.8 (OE), U16.E13 (VIO_1V8)
/LTE/nPWR_CYCLE: C53.1, Q8.3 (C), TP14.1 (1_1), U16.R12 (ON_OFF_N)
/LTE/nSHUTDOWN: C52.1, Q7.3 (C), TP15.1 (1_1), U16.R13 (HW_SHUTDOWN_N)
GND: C44.2, C45.2, C48.2, C49.2, C50.2, C51.2, C52.2, C53.2, C54.2, C55.2, C56.2, C57.2, C62.2, C63.2, C64.2, C65.2, C66.2, C67.2, C68.2, C69.2, C70.2, C71.2, C72.2, C78.2, C79.2, J9.5 (GND), J9.8 (GND), J9.9 (GND), J11.2 (Ext), J11.3 (Ext), J11.4 (PT), Q7.2 (E), Q8.2 (E), Q18.2 (S), R33.2, R34.2, R47.2, R51.2, R52.2, U15.7 (GND), U15.15 (EP), U16.A2 (GND), U16.B13 (GND), U16.D4 (GND), U16.E1 (GND), U16.E2 (GND), U16.E14 (GND), U16.F2 (GND), U16.G1 (GND), U16.G2 (GND), U16.G7 (GND), U16.G8 (GND), U16.G9 (GND), U16.H1 (GND), U16.H2 (GND), U16.H7 (GND), U16.H8 (GND), U16.H9 (GND), U16.J1 (GND), U16.J2 (GND), U16.J7 (GND), U16.J8 (GND), U16.J9 (GND), U16.K2 (GND), U16.L1 (GND), U16.L2 (GND), U16.L14 (C105/RTS), U16.M3 (GND), U16.M4 (GND), U16.M12 (GND), U16.N3 (GND), U16.N4 (GND), U16.N5 (GND), U16.N6 (GND), U16.P3 (GND), U16.P4 (GND), U16.P5 (GND), U16.P6 (GND), U16.P8 (GND), U16.P9 (GND), U16.P10 (GND), U16.P13 (GND), U16.R2 (GND), U16.R3 (GND), U16.R5 (GND), U16.R6 (GND), U16.R8 (GND), U16.R10 (GND); also elsewhere on the board
unnamed: D3.1 (K), R20.1
unnamed: C71.1, J11.1 (In), R46.2
unnamed: Q7.1 (B), R33.1, R35.1
unnamed: Q8.1 (B), R34.1, R36.1
unnamed: Q18.3 (D), R20.2
unnamed: TP10.1 (1_1), U16.F14 (FORCED_USB_BOOT)
unnamed: R51.1, U16.A4 (SIMIN1)
unnamed: R52.1, U16.G4 (SIMIN2)
unnamed: TP11.1 (1_1), U16.P15 (C106/CTS)
unnamed: TP24.1 (1_1), U16.M6 (DEBUG_UART_RXD)
unnamed: TP12.1 (1_1), U16.K4 (DEBUG_UART_TXD)
unnamed: TP8.1 (1_1), U16.B15 (USB_D+)
unnamed: TP9.1 (1_1), U16.C15 (USB_D-)
unnamed: TP7.1 (1_1), U16.A13 (USB_VBUS)

Notes on the sheet:
Auto Off, when module is powered down
MODULE INPUT
PLACE CLOSE TO MODULE
PLACE CLOSE TO THE MODULE
MODULE OUTPUT
EMC Filter
ESP32 drives LTE_SHUTDOWN HIGH to assert emergency reset
HW_SHUTDOWN - only as emergency reset
ESP32 pulses LTE_PWR_CYCLE HIGH for 520ms-3520ms to power on, or >1s to power off
