mszkowalik/CE_Dongle_v3_schematic/src/CE_Dongle_V3.kicad_pcb

## KiCad design src/CE_Dongle_V3.kicad_pcb (continued)

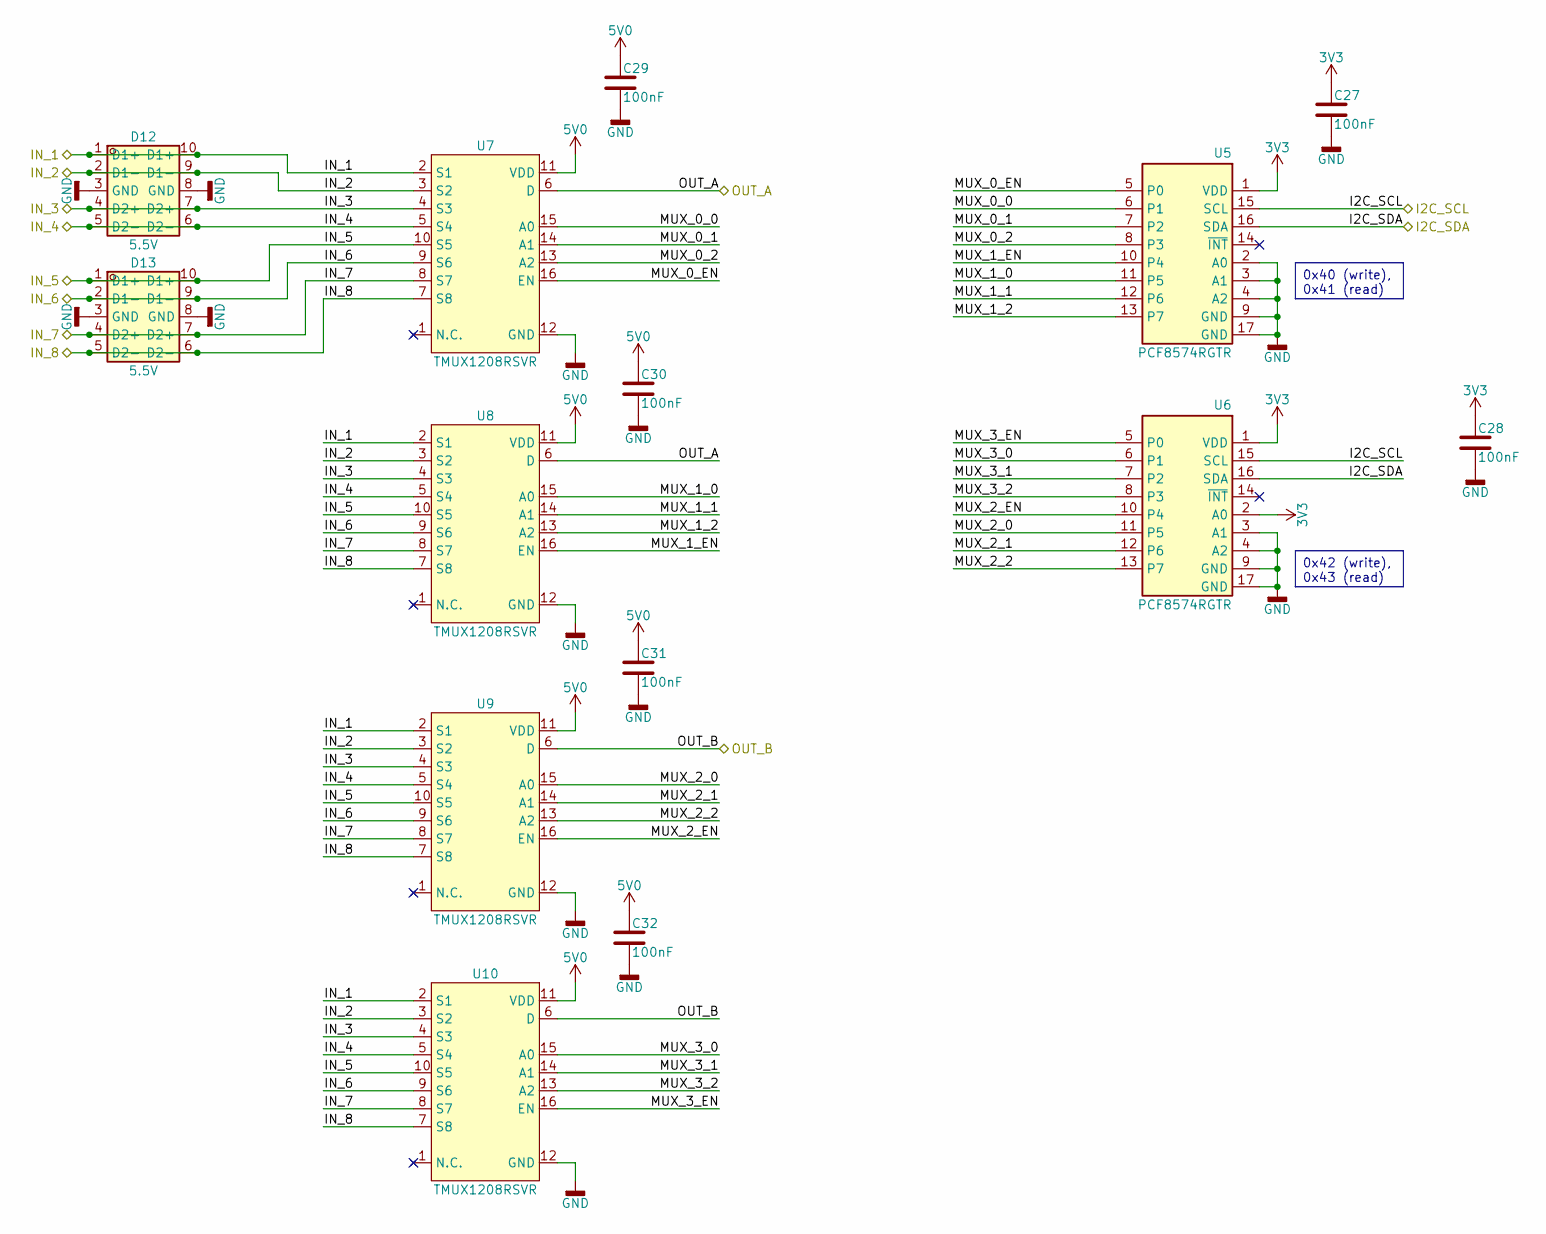
[picture p15: schematic MUX.kicad_sch]

Parts:
C27, C28, C29, C30, C31, C32: 100nF; C_0402_1005Metric; Voltage 16V; Tolerance 10%; Manufacturer Part Numbe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 CL05B104KO5NNNC; LCSC Part C1525
D12, D13: 5.5V; USON-10_2.5x1.0mm_P0.5mm; Voltage - Breakdown 6.5V; LCSC Part C138714
U5, U6: PCF8574RGTR; QFN-16-1EP_3x3mm_P0.5mm_EP1.7x1.7mm_ThermalVias; Manufacturer Part Numbe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 PCF8574RGTR; LCSC Part C22396384
U7, U8, U9, U10: TMUX1208RSVR; UQFN-16_1.8x2.6mm_P0.4mm; Manufacturer Part Numbe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 TMUX1208RSVR; LCSC Part C2673274

Connections:
3V3: C27.1, C28.1, U5.1 (VDD), U6.1 (VDD), U6.2 (A0); also elsewhere on the board
5V0: C29.1, C30.1, C31.1, C32.1, U7.11 (VDD), U8.11 (VDD), U9.11 (VDD), U10.11 (VDD); also elsewhere on the board
/MCU/I2C_SCL: U5.15 (SCL), U6.15 (SCL); also elsewhere on the board
/MCU/I2C_SDA: U5.16 (SDA), U6.16 (SDA); also elsewhere on the board
/MUX/IN_1: D12.1 (D1+), D12.10 (D1+), U7.2 (S1), U8.2 (S1), U9.2 (S1), U10.2 (S1); also elsewhere on the board
/MUX/IN_2: D12.2 (D1-), D12.9 (D1-), U7.3 (S2), U8.3 (S2), U9.3 (S2), U10.3 (S2); also elsewhere on the board
/MUX/IN_3: D12.4 (D2+), D12.7 (D2+), U7.4 (S3), U8.4 (S3), U9.4 (S3), U10.4 (S3); also elsewhere on the board
/MUX/IN_4: D12.5 (D2-), D12.6 (D2-), U7.5 (S4), U8.5 (S4), U9.5 (S4), U10.5 (S4); also elsewhere on the board
/MUX/IN_5: D13.1 (D1+), D13.10 (D1+), U7.10 (S5), U8.10 (S5), U9.10 (S5), U10.10 (S5); also elsewhere on the board
/MUX/IN_6: D13.2 (D1-), D13.9 (D1-), U7.9 (S6), U8.9 (S6), U9.9 (S6), U10.9 (S6); also elsewhere on the board
/MUX/IN_7: D13.4 (D2+), D13.7 (D2+), U7.8 (S7), U8.8 (S7), U9.8 (S7), U10.8 (S7); also elsewhere on the board
/MUX/IN_8: D13.5 (D2-), D13.6 (D2-), U7.7 (S8), U8.7 (S8), U9.7 (S8), U10.7 (S8); also elsewhere on the board
/MUX/MUX_0_0: U5.6 (P1), U7.15 (A0)
/MUX/MUX_0_1: U5.7 (P2), U7.14 (A1)
/MUX/MUX_0_2: U5.8 (P3), U7.13 (A2)
/MUX/MUX_0_EN: U5.5 (P0), U7.16 (EN)
/MUX/MUX_1_0: U5.11 (P5), U8.15 (A0)
/MUX/MUX_1_1: U5.12 (P6), U8.14 (A1)
/MUX/MUX_1_2: U5.13 (P7), U8.13 (A2)
/MUX/MUX_1_EN: U5.10 (P4), U8.16 (EN)
/MUX/MUX_2_0: U6.11 (P5), U9.15 (A0)
/MUX/MUX_2_1: U6.12 (P6), U9.14 (A1)
/MUX/MUX_2_2: U6.13 (P7), U9.13 (A2)
/MUX/MUX_2_EN: U6.10 (P4), U9.16 (EN)
/MUX/MUX_3_0: U6.6 (P1), U10.15 (A0)
/MUX/MUX_3_1: U6.7 (P2), U10.14 (A1)
/MUX/MUX_3_2: U6.8 (P3), U10.13 (A2)
/MUX/MUX_3_EN: U6.5 (P0), U10.16 (EN)
/MUX/OUT_A: U7.6 (D), U8.6 (D); also elsewhere on the board
/MUX/OUT_B: U9.6 (D), U10.6 (D); also elsewhere on the board
GND: C27.2, C28.2, C29.2, C30.2, C31.2, C32.2, D12.3 (GND), D12.8 (GND), D13.3 (GND), D13.8 (GND), U5.2 (A0), U5.3 (A1), U5.4 (A2), U5.9 (GND), U5.17 (GND), U6.3 (A1), U6.4 (A2), U6.9 (GND), U6.17 (GND), U7.12 (GND), U8.12 (GND), U9.12 (GND), U10.12 (GND); also elsewhere on the board

Notes on the sheet:
0x40 (write), 0x41 (read)
0x42 (write), 0x43 (read)

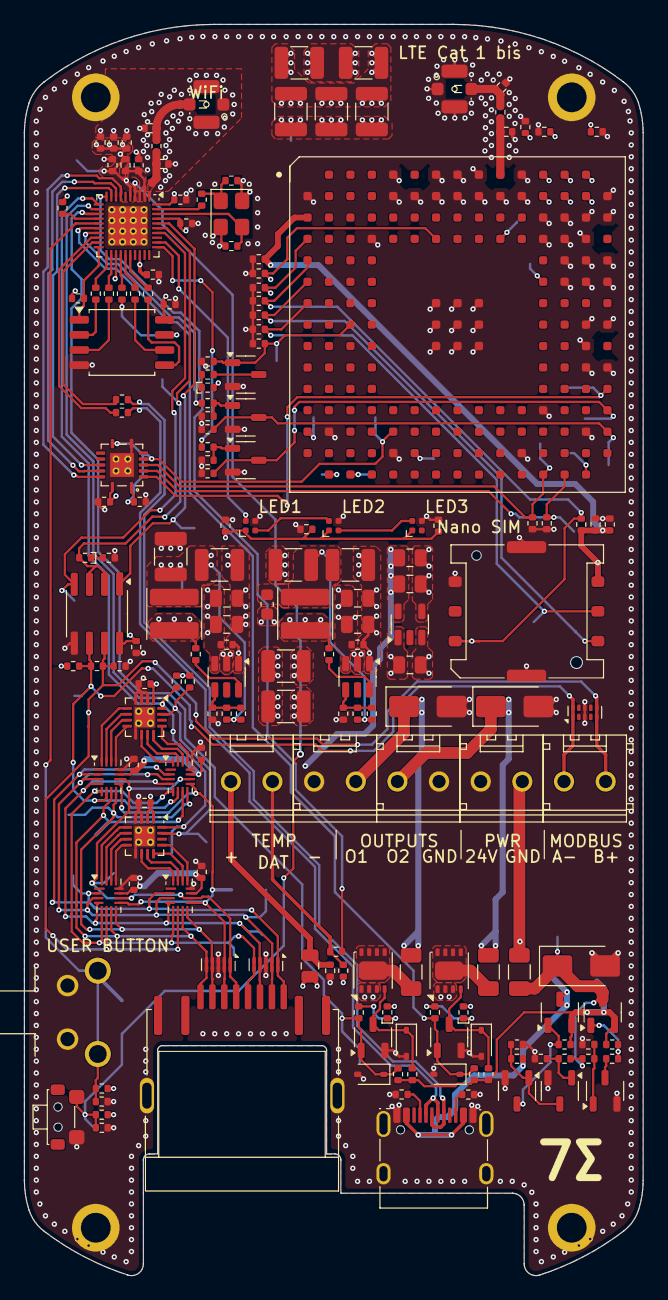
[picture p16: board CE_Dongle_V3.kicad_pcb from above]

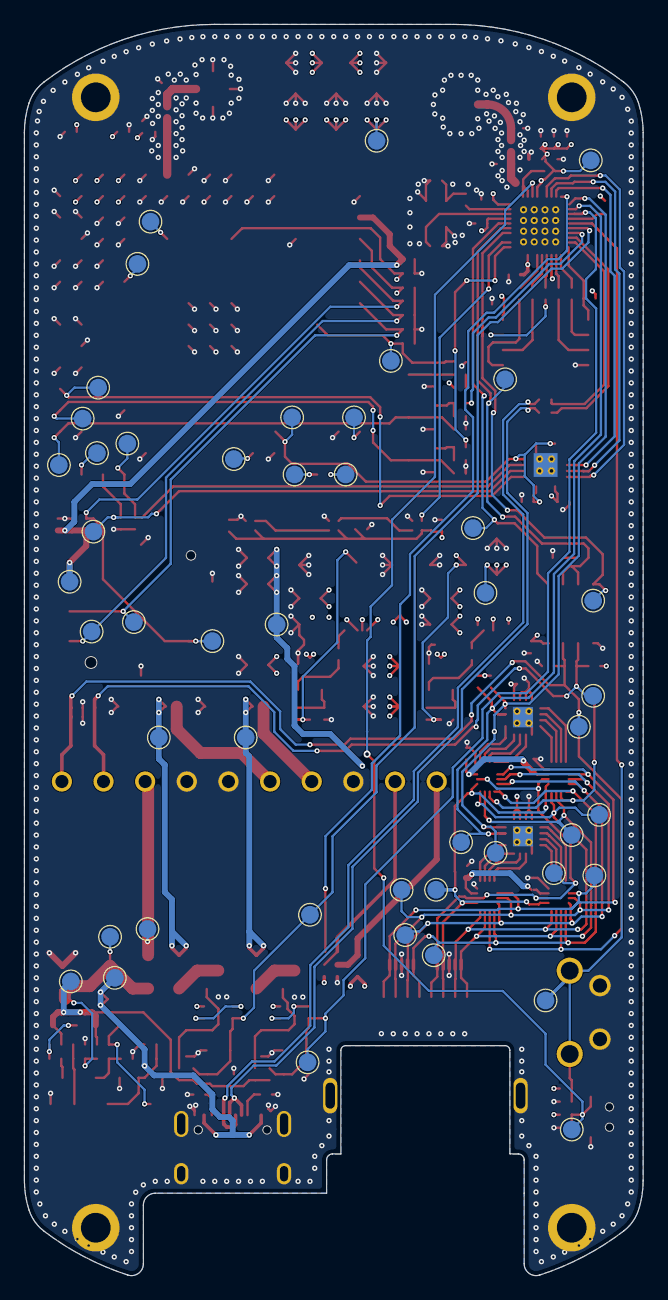
[picture p17: board CE_Dongle_V3.kicad_pcb from below]

Board: 4 copper layers, 52.0 x 105.2 mm, 240 parts (47 on the bottom side), 127 nets.
