mszkowalik/CE_Dongle_v3_schematic/(commit log)

2025-10-18 layout cont. corrected some wrong net names
    [CE_Dongle_V3.kicad_pcb, MCU.kicad_sch, Modbus.kicad_sch]
2025-10-18 layout finished
    [CE_Dongle_V3.kicad_pcb, CE_Dongle_V3.kicad_sch, MCU.kicad_sch, MUX.kicad_sch, Modbus.kicad_sch, PWR.kicad_sch, bom.csv, designators.csv]
2025-11-10 schematic update before production
    [CE_Dongle_V3.kicad_pcb, CE_Dongle_V3.kicad_sch, MCU.kicad_sch, MUX.kicad_sch, PWR.kicad_sch, bom.csv, designators.csv]
2025-11-10 cleaned up repo structure
    [CE_Dongle_V3.kicad_pcb, CE_Dongle_V3.kicad_sch, MCU.kicad_sch, MUX.kicad_sch, Modbus.kicad_sch, PWR.kicad_sch, bom.csv, designators.csv]
2026-05-01 V3.1 first changes
    [1551RFL.igs, 1551RFL.stp, CE_Dongle_V3.kicad_pcb, CE_Dongle_V3.kicad_sch, CE_Dongle_v3_pcb-base.3mf, CE_Dongle_v3_pcb-otwory.3mf, CE_Dongle_v3_pcb.FCStd, EG915U.kicad_sch]
2026-05-09 ongoing work
    [CE_Dongle_V3.kicad_pcb, CE_Dongle_V3.kicad_sch, EG915U.kicad_sch, LE310X1.kicad_sch, LE910R1.kicad_sch, LED.kicad_sch, LTE.kicad_sch, MCU.kicad_sch]
2026-06-02 Layout progress
    [CE_Dongle_V3.kicad_pcb, CE_Dongle_V3.kicad_sch, LE910R1.kicad_sch, LTE.kicad_sch, MCU.kicad_sch, MISC.kicad_sch, MUX.kicad_sch, Modbus.kicad_sch]
2026-06-03 floorplan changed, check in
    [CE_Dongle_V3.kicad_pcb, CE_Dongle_V3_OLD.kicad_pcb, LTE.kicad_sch, MCU.kicad_sch]
2026-06-04 PCB layout continued
    [CE_Dongle_V3.kicad_pcb, CE_Dongle_V3.kicad_sch, MCU.kicad_sch, MISC.kicad_sch]
2026-06-09 pcb work continued
    [CE_Dongle_V3.kicad_sch]
2026-06-09 schematic cleanup, verification. GPIO9 pin pulldown changed to pullup.
    [CE_Dongle_V3.kicad_sch, LE910R1.kicad_sch, LTE.kicad_sch, MCU.kicad_sch, MISC.kicad_sch, MUX.kicad_sch, Modbus.kicad_sch, PWR.kicad_sch]
2026-07-03 final pcb that went to production
    [LTE.kicad_sch, MUX.kicad_sch, PWR.kicad_sch, Unnamed.FCStd, bom.csv, designators.csv, positions.csv]
2026-07-05 Firmware LTE feature set + USB-CDC console fix; checkpoint enclosure/export work
    Bumps the firmware submodule to the LTE PPP driver split + USB-CDC console RX
    fix (details in firmware/CHANGELOG_CE_DONGLE.md 2026-07-05).
    Board-side:
    - src/BRINGUP.md: full LTE bring-up story (data stack, PPP egress, WiFi<->LTE
    failover, driver split, config/diagnostics) + USB-CDC console RX fix write-up.
    - src/tasmota_template_CE_Dongle_V3_2.json: canonical V3_2 device template with
    the new GPIO_LTE_* pin assignments (user_config_override.h is gitignored, so
    this file is the source of truth for the build-dependent GPIO codes).
    - .gitignore: ignore src/.history/ (VS Code Local History, editor-side only).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
    [1551RFL.igs, 1551RFL.stp, 1551XFLGY.stp, CE_Dongle_v3_enc_milling.3mf, CE_Dongle_v3_pcb-base.3mf, CE_Dongle_v3_pcb-otwory.3mf, CE_Dongle_v3_pcb.3mf, bom.csv]
2026-07-16 Update .gitignore and enhance logging for LTE drivers; remove obsolete files
    [CE_Dongle_v3_pcb.3mf]
2026-07-19 Update PCB layout and schematics; add enclosure design files
    Bump firmware submodule to WAN failover scenario-audit hardening +
    zombie-LTE self-heal (round 2).
    [CE_Dongle_V3.kicad_sch, CE_Dongle_V3_3-BodySketch.dxf, CE_Dongle_V3_3.FCStd, LTE.kicad_sch, MCU.kicad_sch, MISC.kicad_sch, MUX.kicad_sch, Modbus.kicad_sch]
2026-07-21 layout continued
    [CE_Dongle_V3.kicad_pcb, LTE.kicad_sch, MCU.kicad_sch]
2026-07-22 layout + lib swap to http library. changed up the 10u and 47u caps for cheaper alternative
    [CE_Dongle_V3.kicad_pcb, CE_Dongle_V3.kicad_sch, EG915U.kicad_sch, LE310X1.kicad_sch, LTE.kicad_sch, MCU.kicad_sch, MISC.kicad_sch, MUX.kicad_sch]
